soleyhyman/LightSound2.0/wired-LightSound-Flora/README.md

# Files for Wired LightSound
This directory contains the files for the wired LightSound version. The contents are as follows:
- LightSound-code-wired-Flora
    - Arduino code for wired LightSound
- 3D-wired-case-files.zip
    - Zip file for both .stl and Fusion360 CAD files for 3D case. The .stl files are used for 3D printing. The .f3d files are only needed if you plan to edit the design.
- Instructions for uploading or modifying the LightSound Arduino code (experienced users only)
- English instructions for wired LightSound assembly and operation, as well as the wiring diagram
- Instrucciones de ensamblaje y operación en español
- Instructions d'assemblage et d'utilisation en français
