soleyhyman/LightSound2.0/wired-LightSound-Flora/English-instructions/en-LightSound-operation-instructions-wired.pdf

## LightSound 2.0 – Wired Version

## Operation Instructions

A. Mancilla (ITeDA), Sóley Hyman (CfA, translated)

WARNINGS and CARE

- Do not expose the sensor to rain or very humid conditions
- Make sure the switch is in the “off” position after use
- Do not hit or drop the device
- Do not touch the light sensor with your finger

Description of the parts of the LightSound

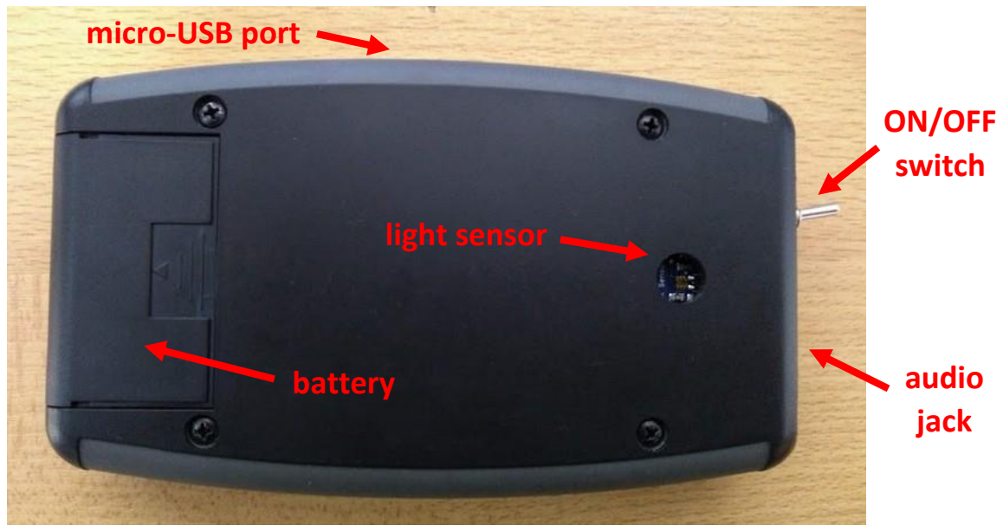
[picture p11: figure]
micro-USB port; ON/OFF switch; audio jack; light sensor; battery

Figure 1: Labeled LightSound 2.0

Parts (Figure 1);

- Audio jack, can connect headphones or speakers
- ON/OFF switch (when not connected to a computer)
- Light sensor
- 9V battery
- Micro USB-B connector

Installing the Battery

1. Make sure the switch is in the OFF position (Figure 2)

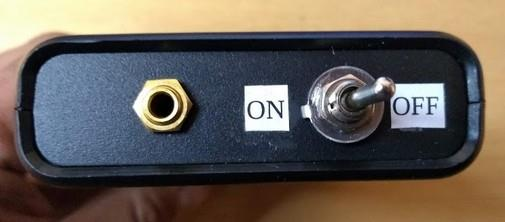
[picture p12: figure]

Figure 2: ON/OFF switch

2. Remove the four screws of the LightSound cover (the side with the raised logo) to access the battery compartment (Figure 3a)

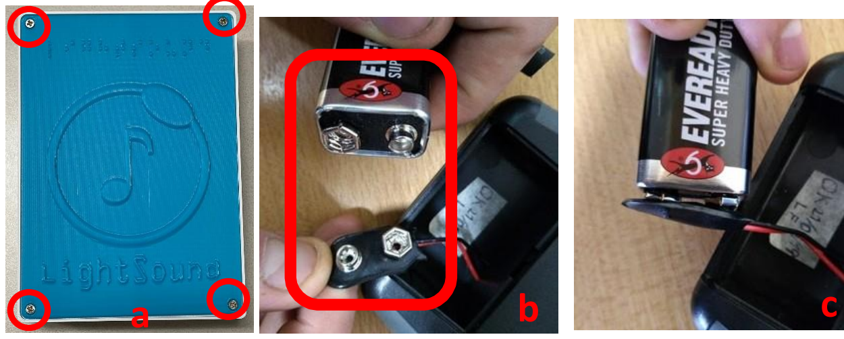
[picture p13: figure]
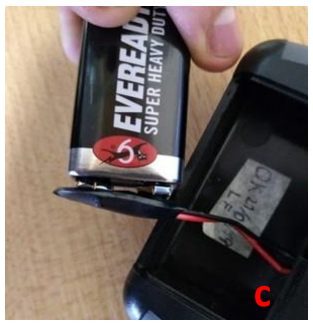
[picture p14: figure]

Figure 3: a) Sliding lid and battery compartment, b) Positioning the battery with respect to the connector, c) Connecting the battery

3. To connect the 9V battery, make sure the connectors are properly aligned (Figure 3b) before snapping the connectors on (Figure 3c).

OPERATION

To hear the sonification, the LightSound must be connected to a headset or speaker.

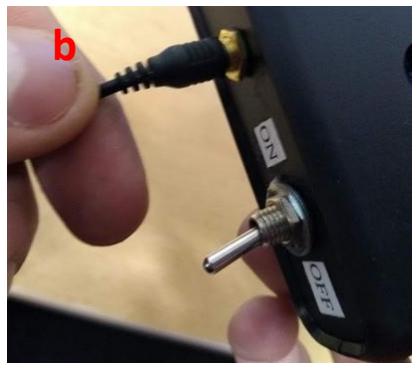
[picture p15: figure]
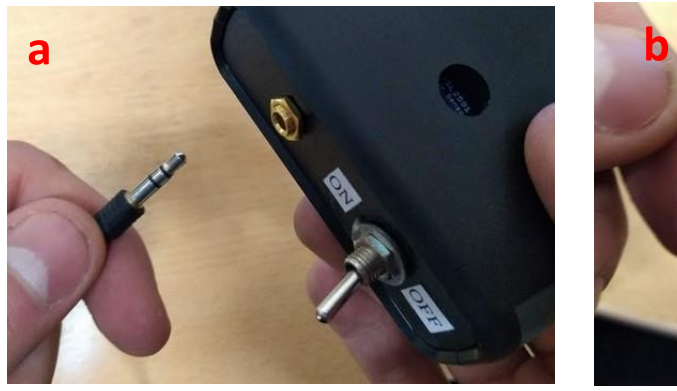
[picture p16: figure]

Figure 4: Audio jack, a) Before connecting, b) After connecting

There are two ways to operate the device:

1. Running off battery power (portable mode)
- In this case, the LightSound can be turned on and off by the switch
2. Connected to a computer (the computer can be plugged in or running off of battery power)
- A micro USB-B cable must be used (Figure 5) to connect the LightSound to the computer
- The battery switch should be in the OFF position when running on the computer power
- Note that the LightSound will run indefinitely when connected to a computer

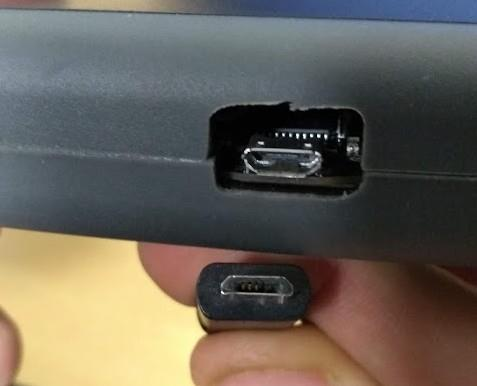
[picture p17: figure]
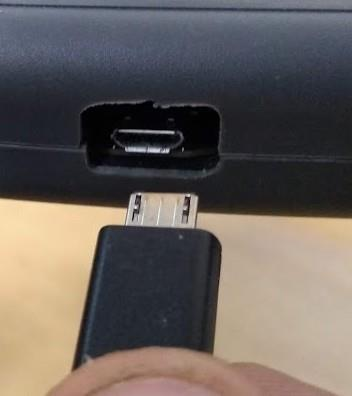
[picture p18: figure]

Figure 5: micro USB-B connector
