soleyhyman/LightSound2.0/wired-LightSound-Flora/Instrucciones-en-español/es-LightSound-Diagrama-de-cableado.pdf

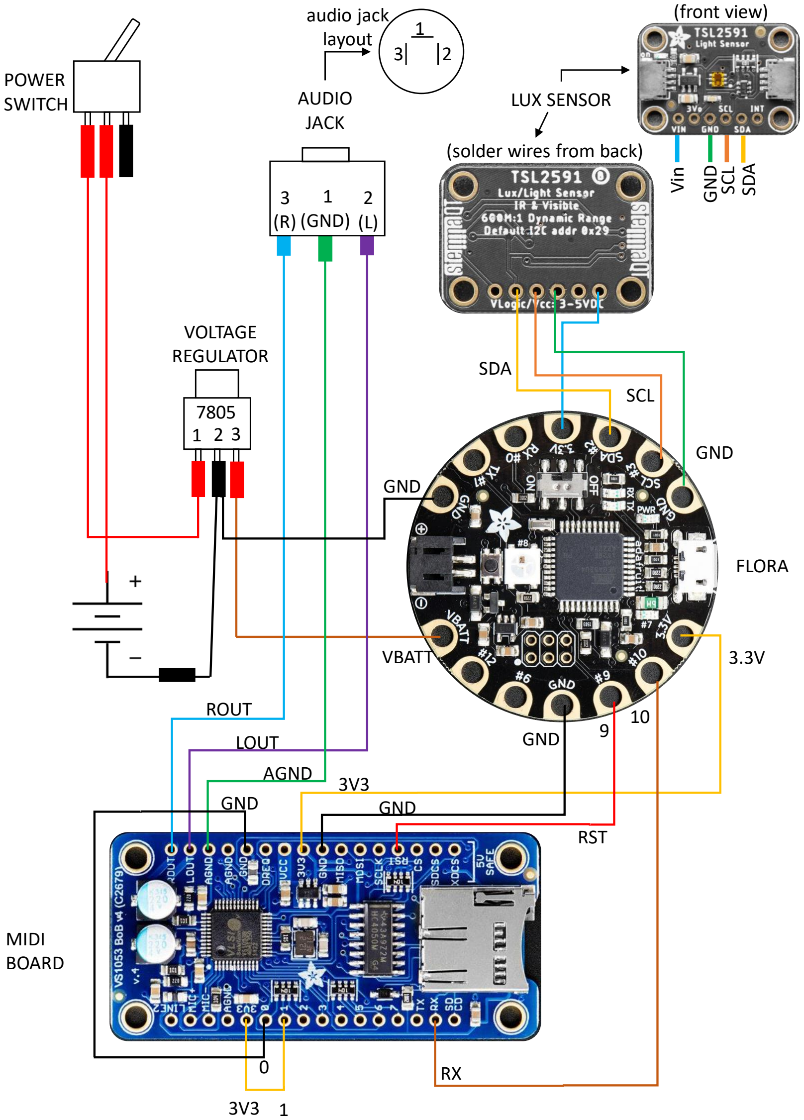
[picture p19: figure]
SCL; SDA; GND; VBATT; Vin; POWER; SWITCH; AUDIO; JACK; LUX SENSOR; RST; LOUT; ROUT; AGND; MIDI BOARD; VOLTAGE REGULATOR; 1 (GND); (solder wires from back); (front view); audio jack layout; FLORA
