soleyhyman/LightSound2.0/wired-LightSound-Flora/Instructions-en-français/fr-LightSound-Schéma-de-branchement.pdf

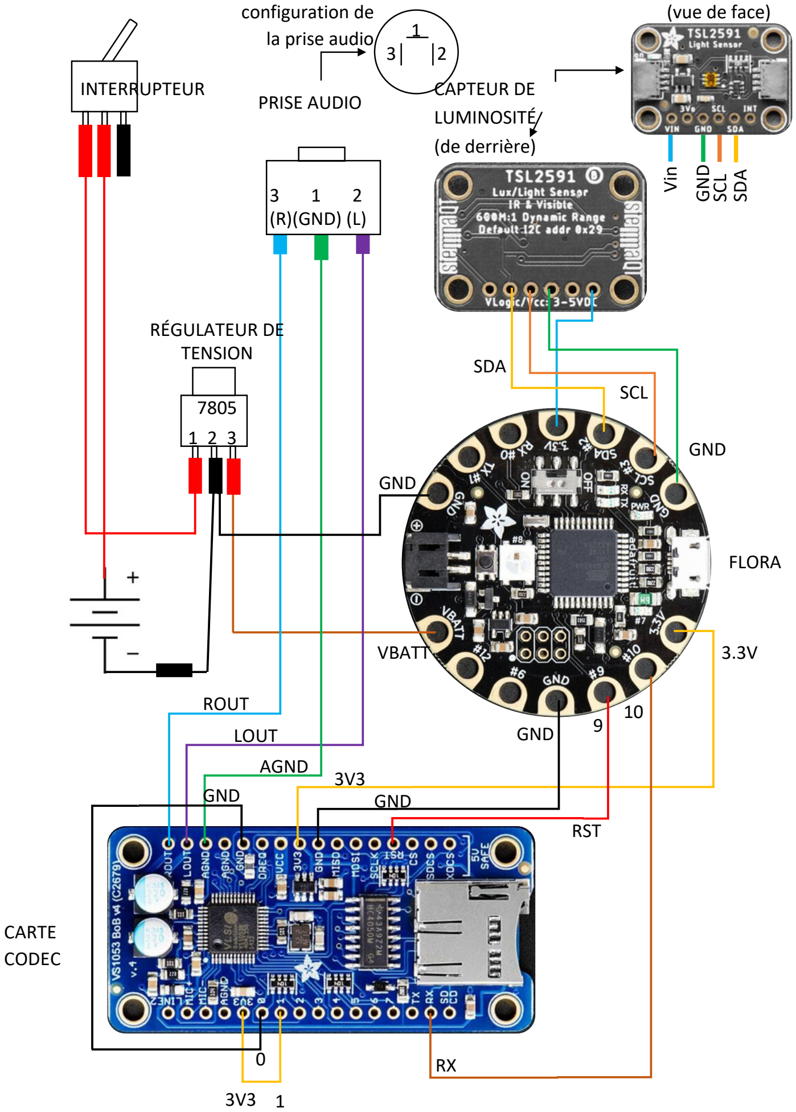
[picture p37: figure]
RÉGULATEUR DE TENSION; ROUT; LOUT; AGND; GND; (R)(GND) (L); PRISE AUDIO; VBATT; SDA; RST; CAPTEUR DE LUMINOSITÉ; (de derrière); SCL; (vue de face); FLORA; INTERRUPTEUR; Vin; CARTE CODEC; configuration de la prise audio
