soleyhyman/LightSound2.0/(threads)

Thread 4 (2019-09-03):

Conflict with Serial Pin 0

HenryDelMal, 2019-09-03:
SoftwareSerial was previously defined to use digital pin 0, conflicting with Arduino's hardware serial.
This can cause some boards to be unusable until reprogrammed via ICSP header (or any other failsafe method depending on the board) due serial being inaccessible (USB port is also connected to serial pins 0 and 1). This behavior has seen in Flora and Arduino Leonardo (both with ATmega32u4 chips).

I propose changing this defined pin to any unused other (like pin 4)  #3

Closed 2023-10-07.

Thread 5 (2023-10-13):

Issue exiting logger code with Ctrl+C sequence

soleyhyman, 2023-10-13:
On newer versions of Python and Matplotlib, there are issues exiting the code, resulting in errors that appear in the serial output, e.g.,
```
Exception ignored in: <function Animation.__del__ at 0x10b8d2a20>
Traceback (most recent call last):
  File "/Users/breeof/anaconda3/lib/python3.11/site-packages/matplotlib/animation.py", line 883, in __del__
     if not getattr(self, '_draw_was_started', True):
```
The current workaround for this is to close the plot window via the red X and press Ctrl+C a few times until it exits. Both the _raw.log and _data.csv files will be saved but the liveplot result will not be.

soleyhyman, 2023-10-13:
This appears to be an issue that only affects Mac machines. As previously stated, the current workaround is to close the plot window via the red X and press Ctrl+C a few times until it exits.

soleyhyman, 2024-03-15:
Fixed in new LightSound Computer Interface software.

Closed 2024-03-15.

Thread 6 (2024-03-22):

Issue with pyinstaller standalone distribution for Mac

soleyhyman, 2024-03-22:
Currently, the standalone application for Mac (produced by pyinstaller) does not find the directory that the application is running from, creating an issue with starting and running the code.

Closed 2024-03-25.

Thread 7 (2024-03-22):

Issue with the port of PCB LightSound being found by the LightSound Interface

soleyhyman, 2024-03-22:
The LightSound interface is not finding the port for PCB LightSounds (with the Feather boards)

Closed 2024-03-25.
