soleyhyman/LightSound2.0/(commit log)

2023-10-07 Fix conflict with Arduino's Serial (Pin 0)
    SoftwareSerial was previously defined to use digital pin 0, conflicting with Arduino's hardware serial.
    This can cause some boards to be unusable until reprogrammed via ICSP header (or any other failsafe method depending on the board) due serial being inaccessible (USB port is also connected to serial pins 0 and 1).
    Is not recommended to use these pins in any way for this reason, so changing to pin 4 as default.
2024-02-13 restructured directories to separate wired and plot/log files
2024-02-13 added wired version instructions files
2024-02-13 added files for PCB versions
2024-02-13 added wired version denotation to comments
2024-02-13 added language folders for wired instructions
2024-03-25 fixed #7 by adding vid 4292 and added PCB dialogs
    [LightSound-Interface-OSX.py, LightSound-Interface-Windows.py]
2024-03-30 Add pcbDlg function to macOS script
    Copy the pcbDlg function from the Windows version of the Python script
    to the macOS version, resolving crashes when called e.g. when the PCB
    was detected on program start-up.
    [LightSound-Interface-OSX.py]
